ryood/RhythmMachine-V2/RhythmMachine Panel/P1110564.jpg

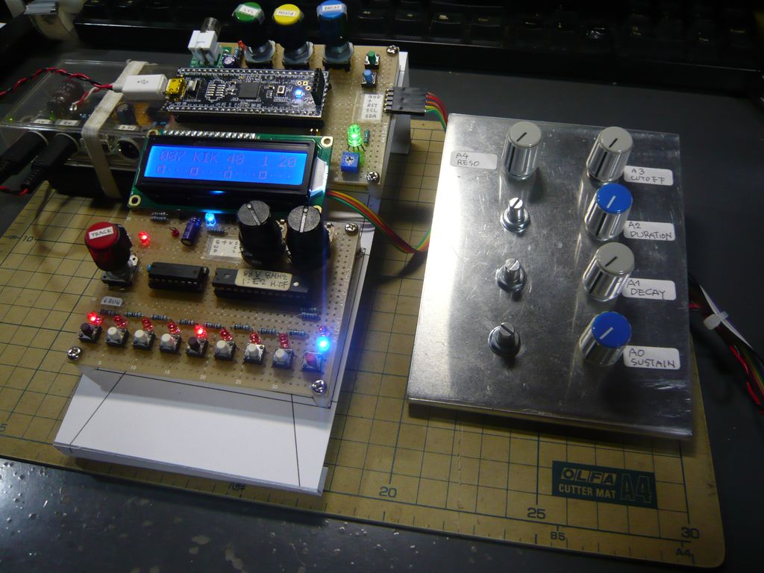
RhythmMachine Panel/P1110564.jpg
