ryood/RhythmMachine-V2/Master_PSoC5LP/Fritzing/PSoC 5LP Prototyping Kit & Sequencer Board & HD44780 REx3_ブレッドボード.png

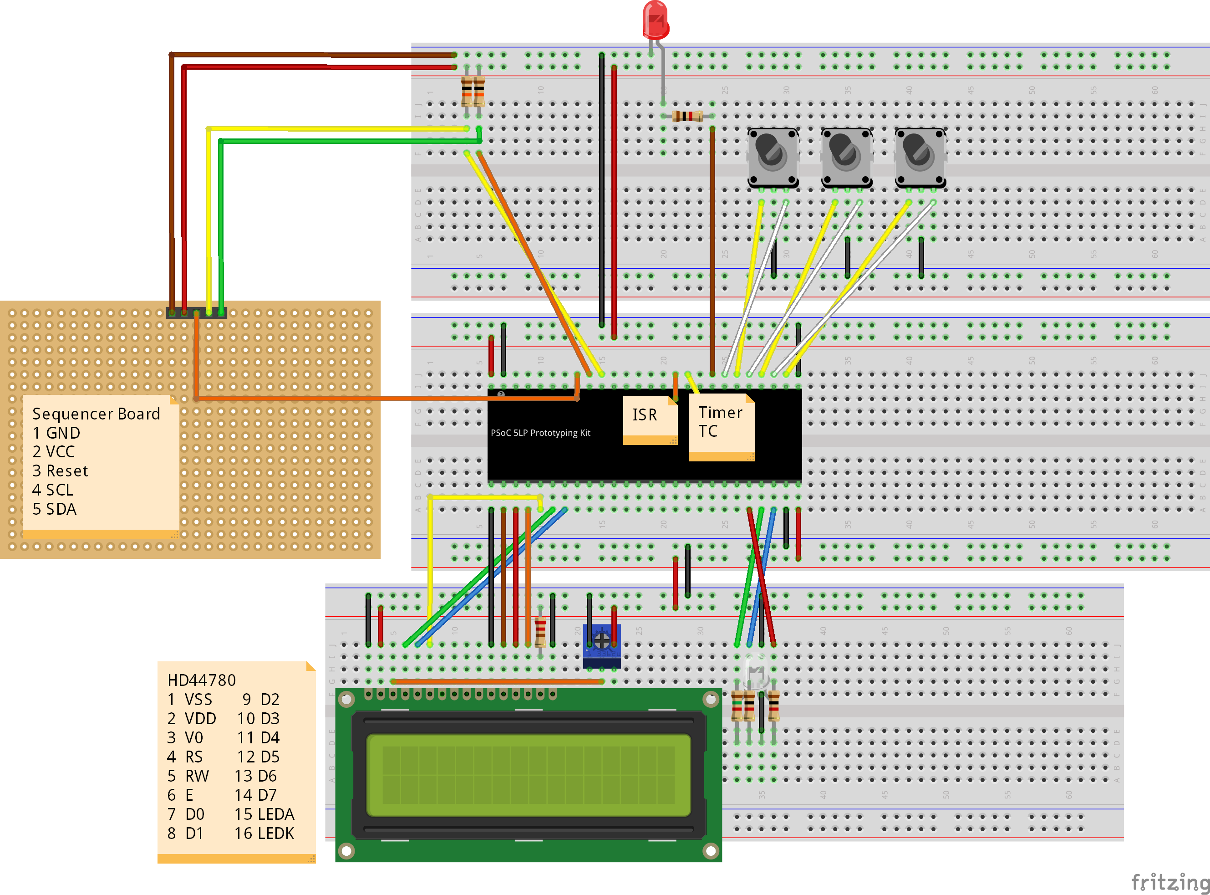
Master_PSoC5LP/Fritzing/PSoC 5LP Prototyping Kit & Sequencer Board & HD44780 REx3_ブレッドボード.png
