ryood/RhythmMachine-V2/Master_PSoC5LP/Fritzing/Rhythm Machine Master PSoC 5LP Prototyping Kit_ブレッドボード.png

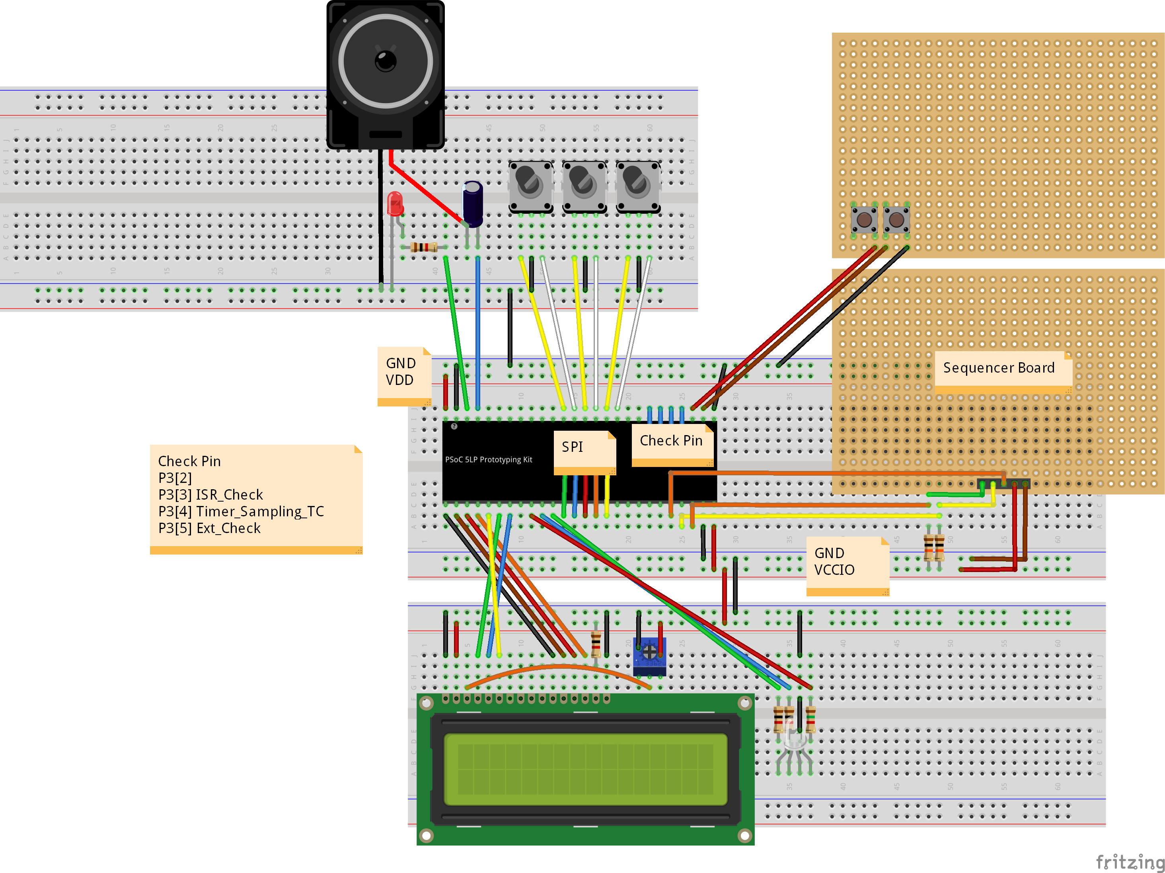
Master_PSoC5LP/Fritzing/Rhythm Machine Master PSoC 5LP Prototyping Kit_ブレッドボード.png
