ryood/RhythmMachine-V2/Master_PSoC5LP/RhythmMachine_Master_Board_Sch.png

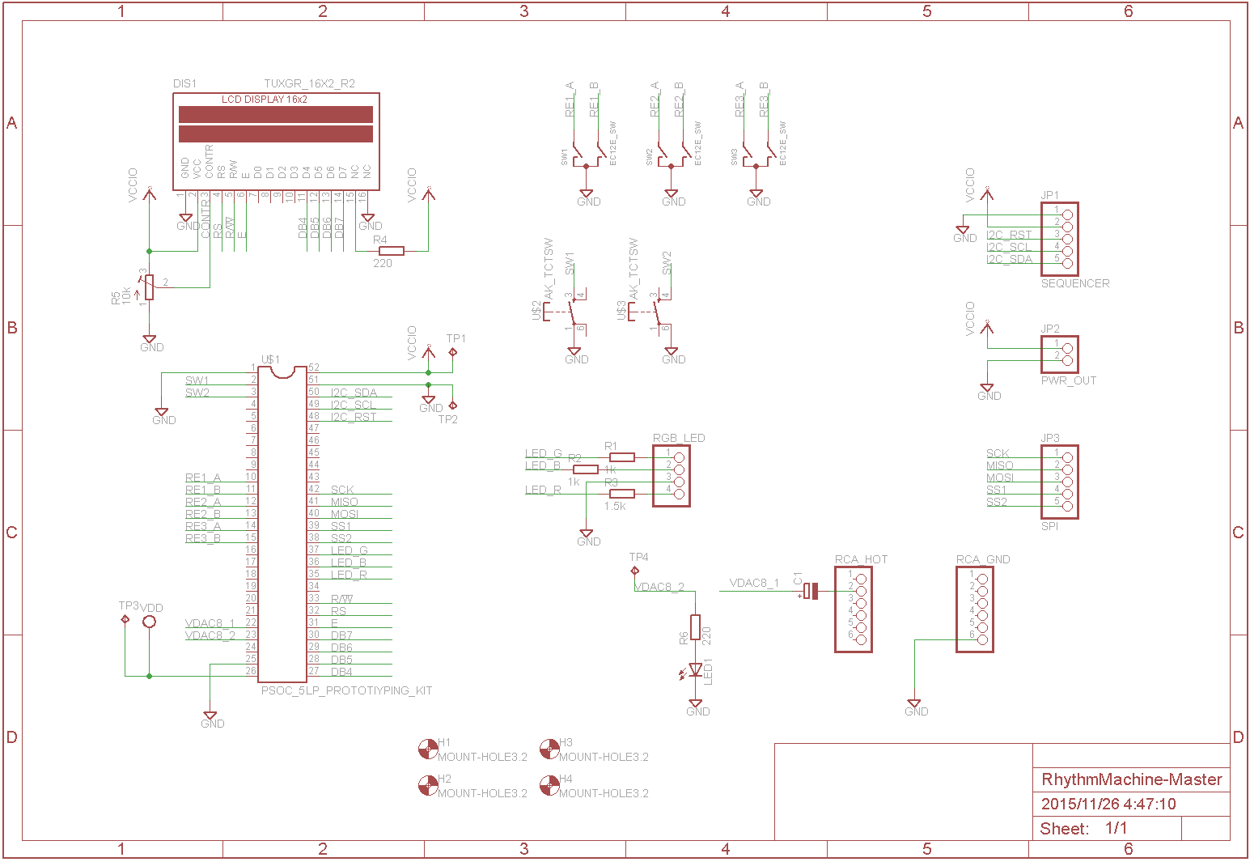
Master_PSoC5LP/RhythmMachine_Master_Board_Sch.png
