ryood/RhythmMachine-V2/Sequencer_Borard/Sequencer_brd.png

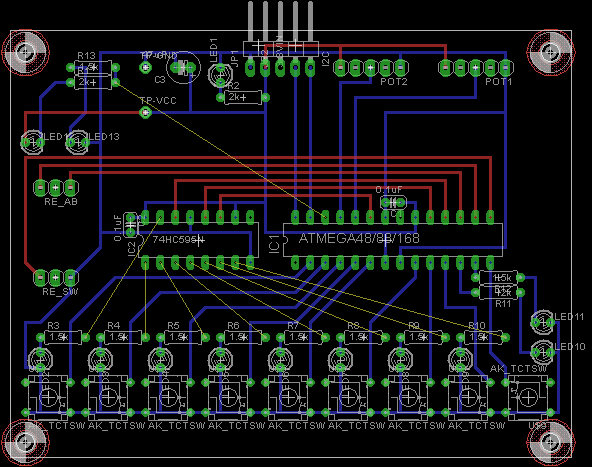
Sequencer_Borard/Sequencer_brd.png
