ryood/RhythmMachine-V2/Sequencer_Borard/Sequencer_IC接続表.png

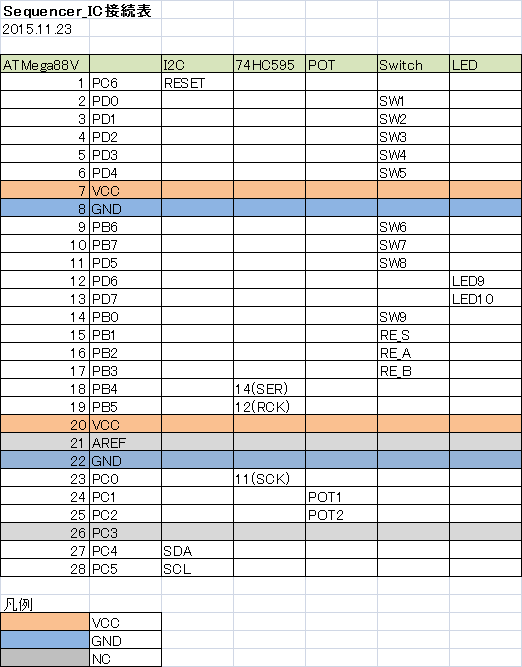
Sequencer_Borard/Sequencer_IC接続表.png
