ryood/RhythmMachine-V2/Sequencer_Borard/Sequencer_sch.png

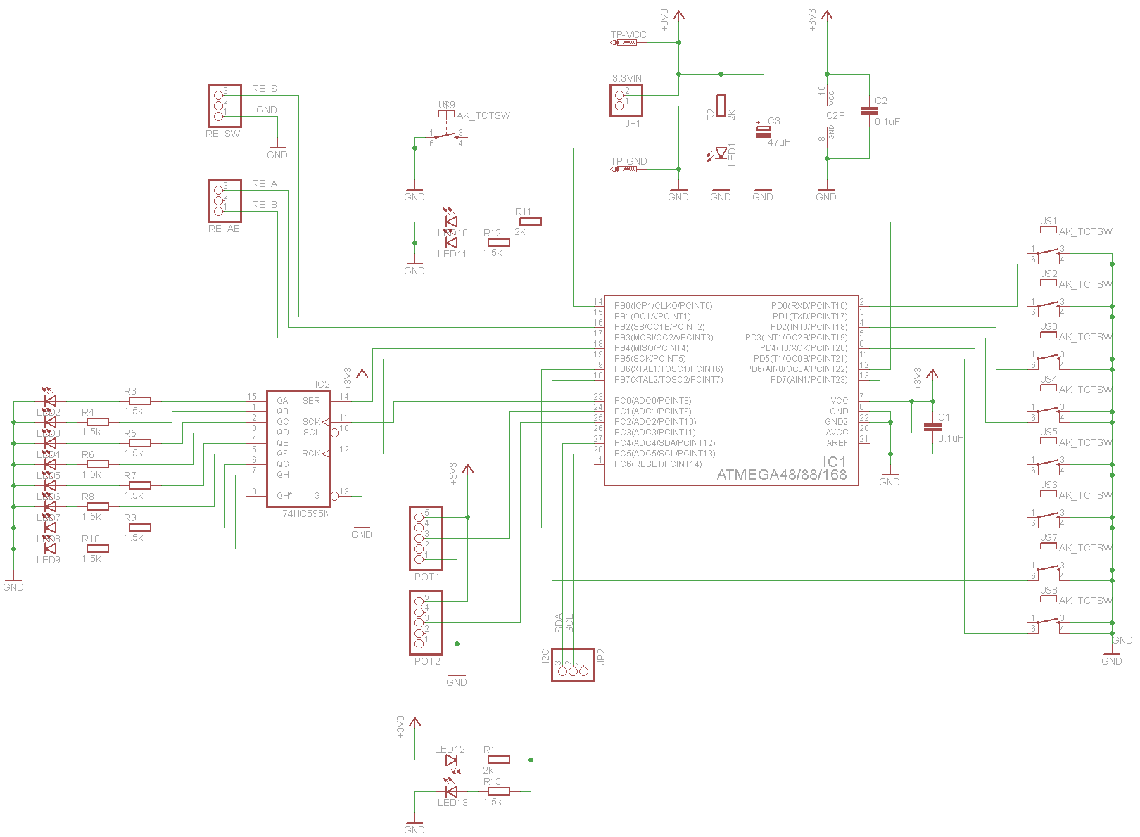
Sequencer_Borard/Sequencer_sch.png
