ryood/RhythmMachine-V2/Rhythm_Machine_I2C_データ・フォーマット.xlsx

Sheet: Sheet1
Rhythm Machine I2C データ・フォーマット
2015.11.15
1) Sequencer Board |  |  | I2C_ADDRESS: 0xFE
1.1) Slave→Master
No. | Sign | Name | 説明 | 備考
1 | unsigned | UPDATE | 変更の有無 | 0:変更なし ※sheet2 *1参照
2 | unsigned | TRACK | トラック番号 | 0..7
3 | unsigned | PLAY | シーケンスの再生フラグ | 1 再生 0:停止
4 | unsigned | SEQUENCE1 | Sequence 1.. 8 | LSBがシーケンス1
5 | unsigned | SEQUENCE2 | Sequence 9..17 | LSBがシーケンス9
6 | unsigned | POT1 | Pot1のADC読み取り値 | 4bit 0..15
7 | unsigned | POT2 | Pot2のADC読み取り値 | 4bit 0..15
1.2) Master→Slave
No. | Sign | Name | 説明 | 備考
1 | unsigned | NOTE | 再生中のノート・ナンバー | 0..15
2) Ext. Board |  |  | I2C_ADDRESS: 0xAA
2.1) Slave→Master
No. | Sign | Name | 説明 | 備考
1 |  | RE1 | ロータリーエンコーダー1の値 | 0..255
2 |  | RE2 | ロータリーエンコーダー2の値 | 0..255
3 |  | RE3 | ロータリーエンコーダー3の値 | 0..255
4 |  | SW | スイッチ（4個）のトグル状態 | B3:SW4 B2:SW3 B1:SW1 B0:SW0
2.2) Master→Slave
No. | Sign | Name | 説明 | 備考
1 |  | RE1 | ロータリーエンコーダー1の値 | 0..255
2 |  | RE2 | ロータリーエンコーダー2の値 | 0..255
3 |  | RE3 | ロータリーエンコーダー3の値 | 0..255
4 |  | SW | スイッチ（4個）のトグル状態 | B3:SW4 B2:SW3 B1:SW1 B0:SW0

Sheet: Sheet2
※1 UPDATE
b7 | b6 | b5 | b4 | b3 | b2 | b1 | b0
- | POT2 | POT1 | SEQUENCE2 | SEQUENCE1 | PLAY | TRACK | -
