ryood/RhythmMachine-V2/(list of files, cad)

Other CAD files:
RhythmMachine Panel/RhythmMachine_Panel.dwg
