ryood/RhythmMachine-V2/Sequencer_Borard/Sequencer_Test.xlsx

Sequencerテスト表
 | 2層目配線前、電源なし、ICの挿入なし
 | 項番 | Point1 | Point2 | 値 | 2015.09.19 #1
 | 1 | IC1-2 | GND | SW1 on/off | ok
 | 2 | IC1-3 | GND | SW2 on/off | ok
 | 3 | IC1-4 | GND | SW3 on/off | ok
 | 4 | IC1-5 | GND | SW4 on/off | ok
 | 5 | IC1-6 | GND | SW5 on/off | ok
 | 6 | IC1-7 | VCC | con | ok
 | 7 | IC1-8 | GND | con | ok
 | 8 | IC1-9 | GND | SW6 on/off | ok
 | 9 | IC1-10 | GND | SW7 on/off | ok
 | 10 | IC1-11 | GND | SW8 on/off | ok
 | 11 | ~~IC1-12~~ | ~~GND~~ | ~~3.3V LED10 on~~
 | 12 | IC1-13 | GND | 3.3V LED11 on | ok
 | 13 | IC1-14 | GND | SW9 on/off | ok
 | 14 | ~~IC1-15~~ | ~~GND~~ | ~~RE_SW on/off~~
 | 15 | ~~IC1-16~~ | ~~GND~~ | ~~RE_A on/off~~
 | 16 | ~~IC1-17~~ | ~~GND~~ | ~~RE_B on/off~~
 | 17 | ~~IC1-18~~ | ~~IC2-14~~ | ~~con~~
 | 18 | ~~IC1-19~~ | ~~IC2-12~~ | ~~con~~
 | 19 | IC1-20 | VCC | con | ok
 | 20 | IC1-21 | VCC/GND | nc | ok
 | 21 | IC1-22 | GND | con | ok
 | 22 | ~~IC1-23~~ | ~~IC2-11~~ | ~~con~~
 | 23 | IC1-24 | POT1-2 | con | ok
 | 24 | IC1-25 | POT2-2 | con | ok
 | 25 | ~~IC1-26~~ | ~~GND~~ | ~~-3.3V LED12 on~~
 | 26 | ~~IC1-26~~ | ~~GND~~ | ~~3.3V LED13 on~~
 | 27 | IC1-27 | JP2-3 | con | ok
 | 28 | IC1-28 | JP2-2 | con | ok
 | 29 | ~~IC2-1~~ | ~~GND~~ | ~~3.3V LED3 on~~
 | 30 | ~~IC2-2~~ | ~~GND~~ | ~~3.3V LED4 on~~
 | 31 | ~~IC2-3~~ | ~~GND~~ | ~~3.3V LED5 on~~
 | 32 | ~~IC2-4~~ | ~~GND~~ | ~~3.3V LED6 on~~
 | 33 | ~~IC2-5~~ | ~~GND~~ | ~~3.3V LED7 on~~
 | 34 | ~~IC2-6~~ | ~~GND~~ | ~~3.3V LED8 on~~
 | 35 | ~~IC2-7~~ | ~~GND~~ | ~~3.3V LED9 on~~
 | 36 | IC2-8 | GND | con | ok
 | 37 | IC2-9 | VCC/GND | nc | ok
 | 38 | IC2-10 | VCC | con | ok
 | 39 | IC2-13 | GND | con | ok
 | 40 | ~~IC2-15~~ | ~~GND~~ | ~~3.3V LED2 on~~
 | 41 | IC2-16 | VCC | con | ok
 | 42 | C1 | VCC | con | ok
 | 43 | C1 | GND | con | ok
 | 44 | C2 | VCC | con | ok
 | 45 | C2 | GND | con | ok
 | 46 | POT1-1 | GND | con | ok
 | 47 | ~~POT1-3~~ | ~~VCC~~ | ~~con~~
 | 48 | POT2-1 | GND | con | ok
 | 49 | ~~POT2-3~~ | ~~VCC~~ | ~~con~~
 | 50 | JP1-1 | GND | con | ok
 | 51 | JP1-2 | VCC | con | ok
 | 52 | TP-VCC | TP-GND | 3.3V LED1 on | ok
 | 53 | C3 | VCC | con | ok
 | 54 | C3 | GND | con | ok
 | 電源なし、ICの挿入なし
 | 項番 | Point1 | Point2 | 値 | 2015.09.21 #1
 | 1 | IC1-2 | GND | SW1 on/off | ok
 | 2 | IC1-3 | GND | SW2 on/off | ok
 | 3 | IC1-4 | GND | SW3 on/off | ok
 | 4 | IC1-5 | GND | SW4 on/off | ok
 | 5 | IC1-6 | GND | SW5 on/off | ok
 | 6 | IC1-7 | VCC | con | ok
 | 7 | IC1-8 | GND | con | ok
 | 8 | IC1-9 | GND | SW6 on/off | ok
 | 9 | IC1-10 | GND | SW7 on/off | ok
 | 10 | IC1-11 | GND | SW8 on/off | ok
 | 11 | IC1-12 | GND | 3.3V LED10 on | ok
 | 12 | IC1-13 | GND | 3.3V LED11 on | ok
 | 13 | IC1-14 | GND | SW9 on/off | ok
 | 14 | IC1-15 | GND | RE_SW on/off | ok
 | 15 | IC1-16 | GND | RE_A on/off | ok
 | 16 | IC1-17 | GND | RE_B on/off | ok
 | 17 | IC1-18 | IC2-14 | con | ok
 | 18 | IC1-19 | IC2-12 | con | ok
 | 19 | IC1-20 | VCC | con | ok
 | 20 | IC1-21 | VCC/GND | nc | ok
 | 21 | IC1-22 | GND | con | ok
 | 22 | IC1-23 | IC2-11 | con | ok
 | 23 | IC1-24 | POT1-2 | con | ok
 | 24 | IC1-25 | POT2-2 | con | ok
 | 25 | IC1-26 | GND | -3.3V LED12 on | ok
 | 26 | IC1-26 | GND | 3.3V LED13 on | ok
 | 27 | IC1-27 | JP2-3 | con | ok
 | 28 | IC1-28 | JP2-2 | con | ok
 | 29 | IC2-1 | GND | 3.3V LED3 on | ok
 | 30 | IC2-2 | GND | 3.3V LED4 on | ok
 | 31 | IC2-3 | GND | 3.3V LED5 on | ok
 | 32 | IC2-4 | GND | 3.3V LED6 on | ok
 | 33 | IC2-5 | GND | 3.3V LED7 on | ok
 | 34 | IC2-6 | GND | 3.3V LED8 on | ok
 | 35 | IC2-7 | GND | 3.3V LED9 on | ok
 | 36 | IC2-8 | GND | con | ok
 | 37 | IC2-9 | VCC/GND | nc | ok
 | 38 | IC2-10 | VCC | con | ok
 | 39 | IC2-13 | GND | con | ok
 | 40 | IC2-15 | GND | 3.3V LED2 on | ok
 | 41 | IC2-16 | VCC | con | ok
 | 42 | C1 | VCC | con | ok
 | 43 | C1 | GND | con | ok
 | 44 | C2 | VCC | con | ok
 | 45 | C2 | GND | con | ok
 | 46 | POT1-1 | GND | con | ok
 | 47 | POT1-3 | VCC | con | ok
 | 48 | POT2-1 | GND | con | ok
 | 49 | POT2-3 | VCC | con | ok
 | 50 | JP1-1 | GND | con | ok
 | 51 | JP1-2 | VCC | con | ok
 | 52 | TP-VCC | TP-GND | 3.3V LED1 on | ok
 | 53 | C3 | VCC | con | ok
 | 54 | C3 | GND | con | ok
 | 電源3.3V、ICの挿入なし
 | 項番 | Point1 | Point2 | 値 | 2015.09.21#1
 | 1 | IC1-7 | GND | 3.3V | 3.36V
 | 2 | IC1-8 | GND | 0V | 0.0mV
 | 3 | IC1-20 | GND | 3.3V | 3.36V
 | 4 | IC1-22 | GND | 0V | 0.0mV
 | 5 | IC2-8 | GND | 0V | 0.0mV
 | 6 | IC2-16 | GND | 3.3V | 3.36V
 | 7 | VCC | GND | 3.3V | 3.36V
