ryood/RhythmMachine-V2/(list of files, drawings)

Other design files:
Master_PSoC5LP/Fritzing/PSoC 5LP Prototyping Kit & Sequencer Board & HD44780 REx3.fzz
Sequencer_Borard/Fritzing/Sequencer_02.fzz
Sequencer_Borard/Fritzing/Sequencer_03.fzz
