ryood/RhythmMachine-V2/Master_PSoC5LP/eagle/RhythmMachine-Master/RhythmMachine-Master.brd

## EAGLE design Master_PSoC5LP/eagle/RhythmMachine-Master/RhythmMachine-Master.brd (2016-12-20)

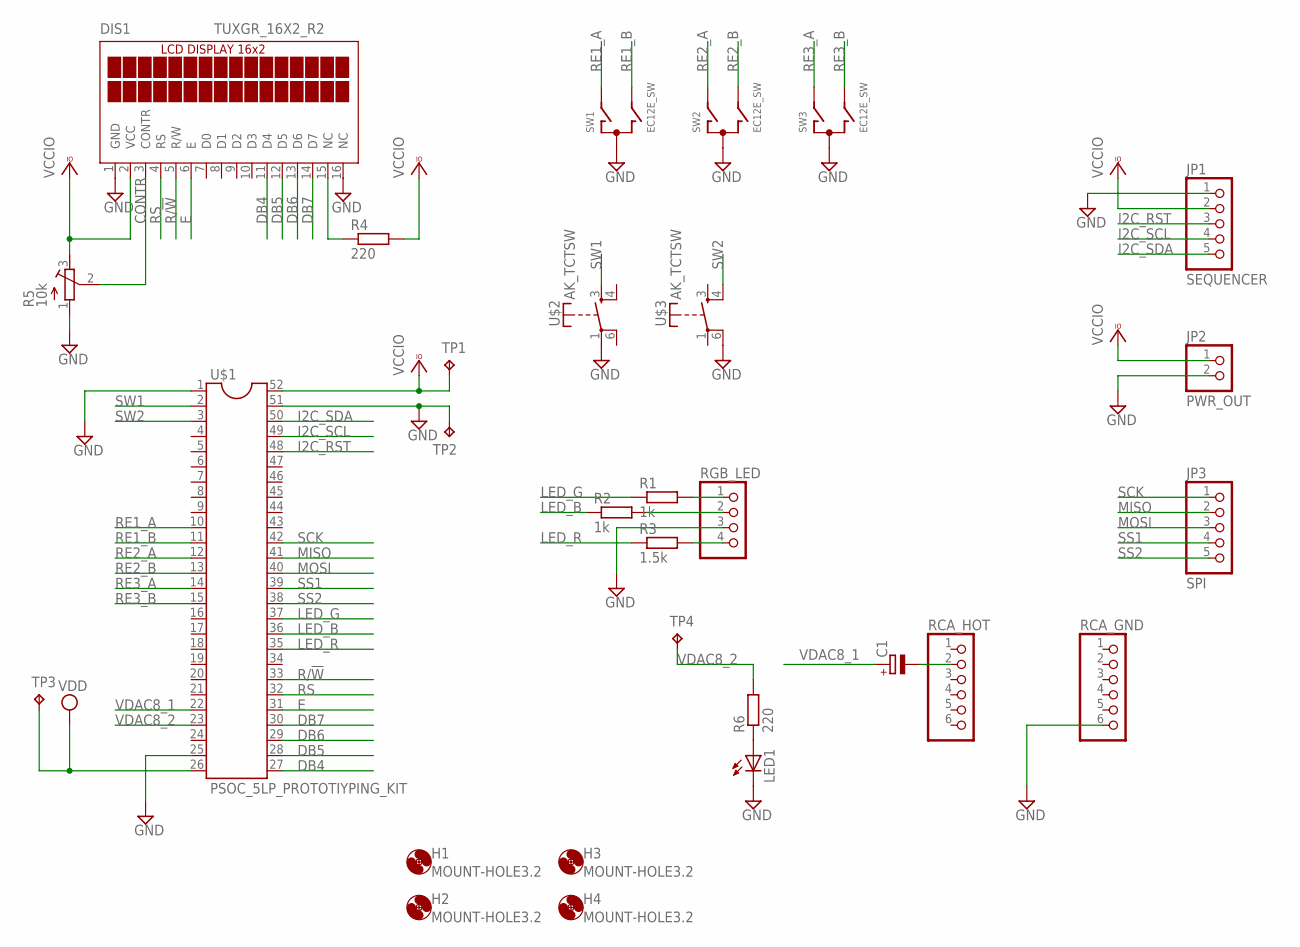
[picture p9: schematic RhythmMachine-Master.sch]

Parts:
C1: CPOL-EUE2.5-7; E2,5-7
DIS1: TUXGR_16X2_R2
H1, H2, H3, H4: MOUNT-HOLE3.2; 3,2
JP1: SEQUENCER; 1X05/90
JP2: PWR_OUT; 1X02/90
JP3: SPI; 1X05/90
LED1: LED3MM
R1, R2: 1k; 0207/7
R3: 1.5k; 0207/7
R4, R6: 220; 0207/7
R5: 10k; RTRIM3339P
RCA_GND: PINHD-1X6; 1X06
RCA_HOT: PINHD-1X6; 1X06
RGB_LED: PINHD-1X4; 1X04
SW1, SW2, SW3: EC12E_SW; ALPS_EC12E_SW
TP1, TP2, TP3, TP4: TPPAD1-13; P1-13
U$1: PSOC_5LP_PROTOTIYPING_KIT; DIL52-8
U$2, U$3: AK_TCTSW; TME1

Connections:
CONTR: DIS1.3 (CONTR), R5.2 (S)
DB4: DIS1.11 (D4), U$1.27
DB5: DIS1.12 (D5), U$1.28
DB6: DIS1.13 (D6), U$1.29
DB7: DIS1.14 (D7), U$1.30
E: DIS1.6 (E), U$1.31
GND: DIS1.1 (GND), DIS1.16 (NC), JP1.1, JP2.2, LED1.K (C), R5.1 (A), RCA_GND.6, RGB_LED.3, SW1.C, SW2.C, SW3.C, TP2.TP, U$1.1, U$1.25, U$1.51, U$2.1, U$3.6
I2C_RST: JP1.3, U$1.48
I2C_SCL: JP1.4, U$1.49
I2C_SDA: JP1.5, U$1.50
LED_B: R2.1, U$1.36
LED_G: R1.1, U$1.37
LED_R: R3.1, U$1.35
MISO: JP3.2, U$1.41
MOSI: JP3.3, U$1.40
unnamed: R1.2, RGB_LED.1
unnamed: R2.2, RGB_LED.2
unnamed: R3.2, RGB_LED.4
unnamed: DIS1.15 (NC), R4.1
unnamed: LED1.A, R6.1
unnamed: C1.-, RCA_HOT.2
R/!W: DIS1.5 (R/W), U$1.33
RE1_A: SW1.A, U$1.10
RE1_B: SW1.B, U$1.11
RE2_A: SW2.A, U$1.12
RE2_B: SW2.B, U$1.13
RE3_A: SW3.A, U$1.14
RE3_B: SW3.B, U$1.15
RS: DIS1.4 (RS), U$1.32
SCK: JP3.1, U$1.42
SS1: JP3.4, U$1.39
SS2: JP3.5, U$1.38
SW1: U$1.2, U$2.3 (S)
SW2: U$1.3, U$3.4 (S)
VCCIO: DIS1.2 (VCC), JP1.2, JP2.1, R4.2, R5.3 (E), TP1.TP, U$1.52
VDAC8_1: C1.+, U$1.22
VDAC8_2: R6.2, TP4.TP, U$1.23
VDD: TP3.TP, U$1.26

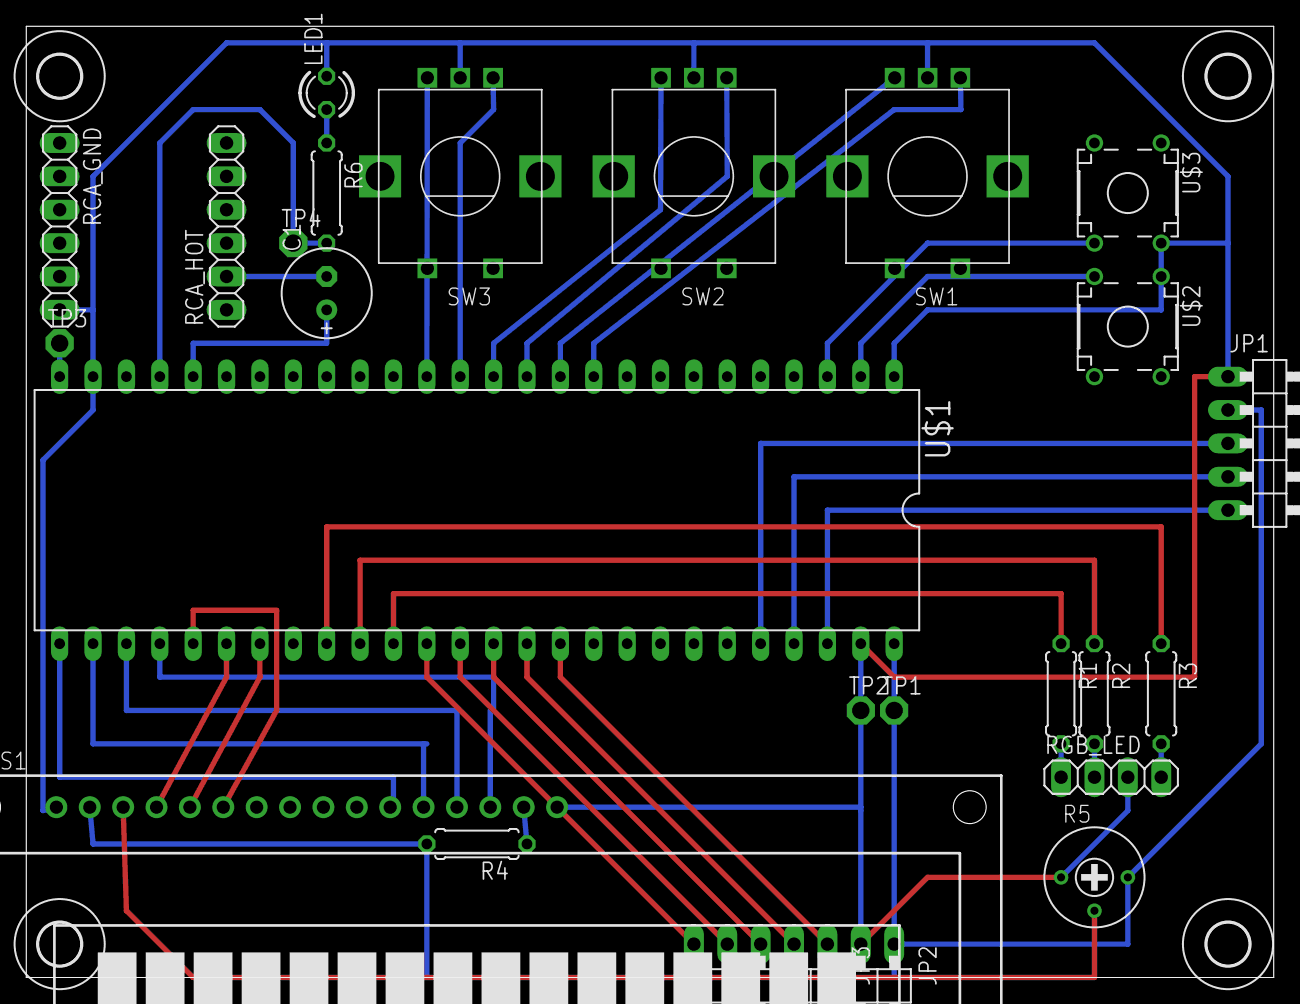
[picture p10: board RhythmMachine-Master.brd from above]

Board: 2 copper layers, 94.9 x 72.4 mm, 29 parts (0 on the bottom side), 38 nets.
