ryood/RhythmMachine-V2/Sequencer_Borard/eagle/Seaquencer.brd

## EAGLE design Sequencer_Borard/eagle/Seaquencer.brd (2016-12-20)

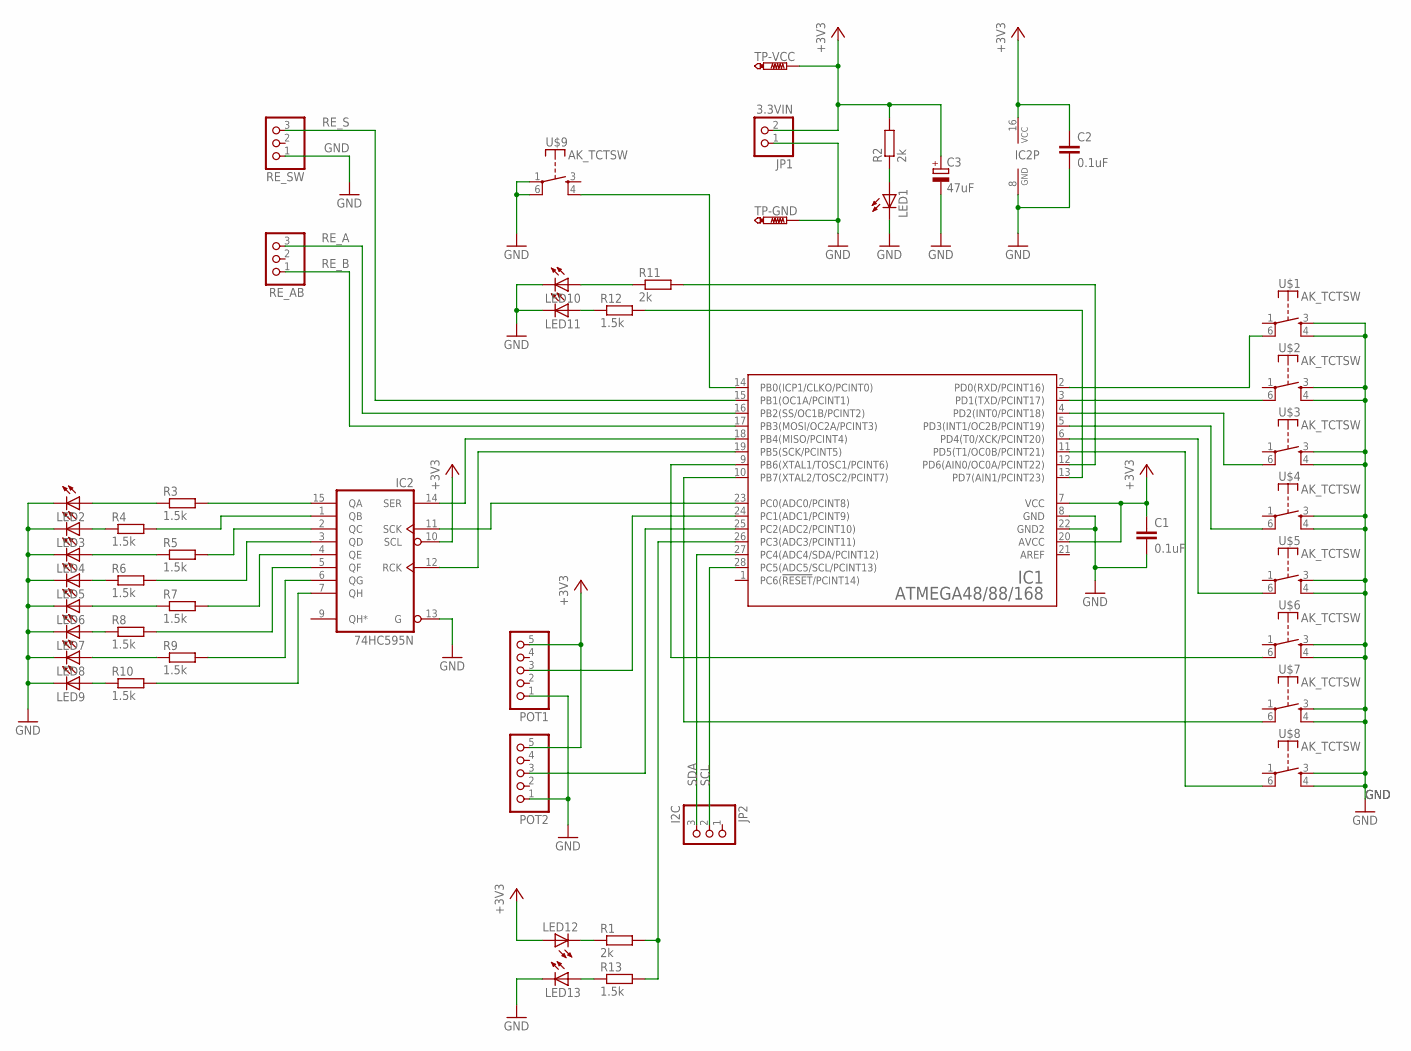
[picture p11: schematic Seaquencer.sch]

Parts:
C1, C2: 0.1uF; C025-024X044
C3: 47uF; E2,5-6
IC1: ATMEGA48/88/168; DIL28-3
IC2: 74HC595N; DIL16
JP1: 3.3VIN; 1X02/90
JP2: I2C; 1X03/90
LED1, LED2, LED3, LED4, LED5, LED6, LED7, LED8, LED9, LED10, LED11, LED12, LED13: LED3MM
POT1, POT2: PINHD-1X5; 1X05
R1, R2, R11: 2k; 0207/7
R3, R4, R5, R6, R7, R8, R9, R10, R12, R13: 1.5k; 0207/7
RE_AB: PINHD-1X3; 1X03
RE_SW: PINHD-1X3; 1X03
TP-GND: PTR1PAD1-13; P1-13
TP-VCC: PTR1PAD1-13; P1-13
U$1, U$2, U$3, U$4, U$5, U$6, U$7, U$8, U$9: AK_TCTSW; TME1

Connections:
+3V3: C1.1, C2.1, C3.+, IC1.7 (VCC), IC1.20 (AVCC), IC2.10 (SCL), IC2.16 (VCC), JP1.2, LED12.A, POT1.5, POT2.5, R2.2, TP-VCC.TP
GND: C1.2, C2.2, C3.-, IC1.8 (GND), IC1.22 (GND2), IC2.8 (GND), IC2.13 (G), JP1.1, LED1.K (C), LED2.K (C), LED3.K (C), LED4.K (C), LED5.K (C), LED6.K (C), LED7.K (C), LED8.K (C), LED9.K (C), LED10.K (C), LED11.K (C), LED13.K (C), POT1.1, POT2.1, RE_SW.1, TP-GND.TP, U$1.3 (S), U$1.4 (S), U$2.3 (S), U$2.4 (S), U$3.3 (S), U$3.4 (S), U$4.3 (S), U$4.4 (S), U$5.3 (S), U$5.4 (S), U$6.3 (S), U$6.4 (S), U$7.3 (S), U$7.4 (S), U$8.3 (S), U$8.4 (S), U$9.1, U$9.6
unnamed: IC1.2 (PD0(RXD/PCINT16)), U$1.6
unnamed: IC1.3 (PD1(TXD/PCINT17)), U$2.6
unnamed: IC1.11 (PD5(T1/OC0B/PCINT21)), U$8.6
unnamed: IC1.10 (PB7(XTAL2/TOSC2/PCINT7)), U$7.6
unnamed: IC1.9 (PB6(XTAL1/TOSC1/PCINT6)), U$6.6
unnamed: IC1.6 (PD4(T0/XCK/PCINT20)), U$5.6
unnamed: IC1.5 (PD3(INT1/OC2B/PCINT19)), U$4.6
unnamed: IC1.18 (PB4(MISO/PCINT4)), IC2.14 (SER)
unnamed: IC1.23 (PC0(ADC0/PCINT8)), IC2.11 (SCK)
unnamed: IC1.24 (PC1(ADC1/PCINT9)), POT1.3
unnamed: IC1.25 (PC2(ADC2/PCINT10)), POT2.3
unnamed: IC1.19 (PB5(SCK/PCINT5)), IC2.12 (RCK)
unnamed: IC1.14 (PB0(ICP1/CLKO/PCINT0)), U$9.4 (S)
unnamed: IC1.26 (PC3(ADC3/PCINT11)), R1.2, R13.2
unnamed: LED1.A, R2.1
unnamed: IC2.15 (QA), R3.2
unnamed: IC2.1 (QB), R4.2
unnamed: IC2.2 (QC), R5.2
unnamed: IC2.3 (QD), R6.2
unnamed: IC2.4 (QE), R7.2
unnamed: IC2.5 (QF), R8.2
unnamed: IC2.6 (QG), R9.2
unnamed: IC2.7 (QH), R10.2
unnamed: LED2.A, R3.1
unnamed: LED3.A, R4.1
unnamed: LED4.A, R5.1
unnamed: LED5.A, R6.1
unnamed: LED6.A, R7.1
unnamed: LED7.A, R8.1
unnamed: LED8.A, R9.1
unnamed: LED9.A, R10.1
unnamed: LED12.K (C), R1.1
unnamed: LED11.A, R12.1
unnamed: LED10.A, R11.1
unnamed: IC1.13 (PD7(AIN1/PCINT23)), R12.2
unnamed: IC1.12 (PD6(AIN0/OC0A/PCINT22)), R11.2
unnamed: LED13.A, R13.1
unnamed: IC1.4 (PD2(INT0/PCINT18)), U$3.6
RE_A: IC1.16 (PB2(SS/OC1B/PCINT2)), RE_AB.3
RE_B: IC1.17 (PB3(MOSI/OC2A/PCINT3)), RE_AB.1
RE_S: IC1.15 (PB1(OC1A/PCINT1)), RE_SW.3
SCL: IC1.28 (PC5(ADC5/SCL/PCINT13)), JP2.2
SDA: IC1.27 (PC4(ADC4/SDA/PCINT12)), JP2.3

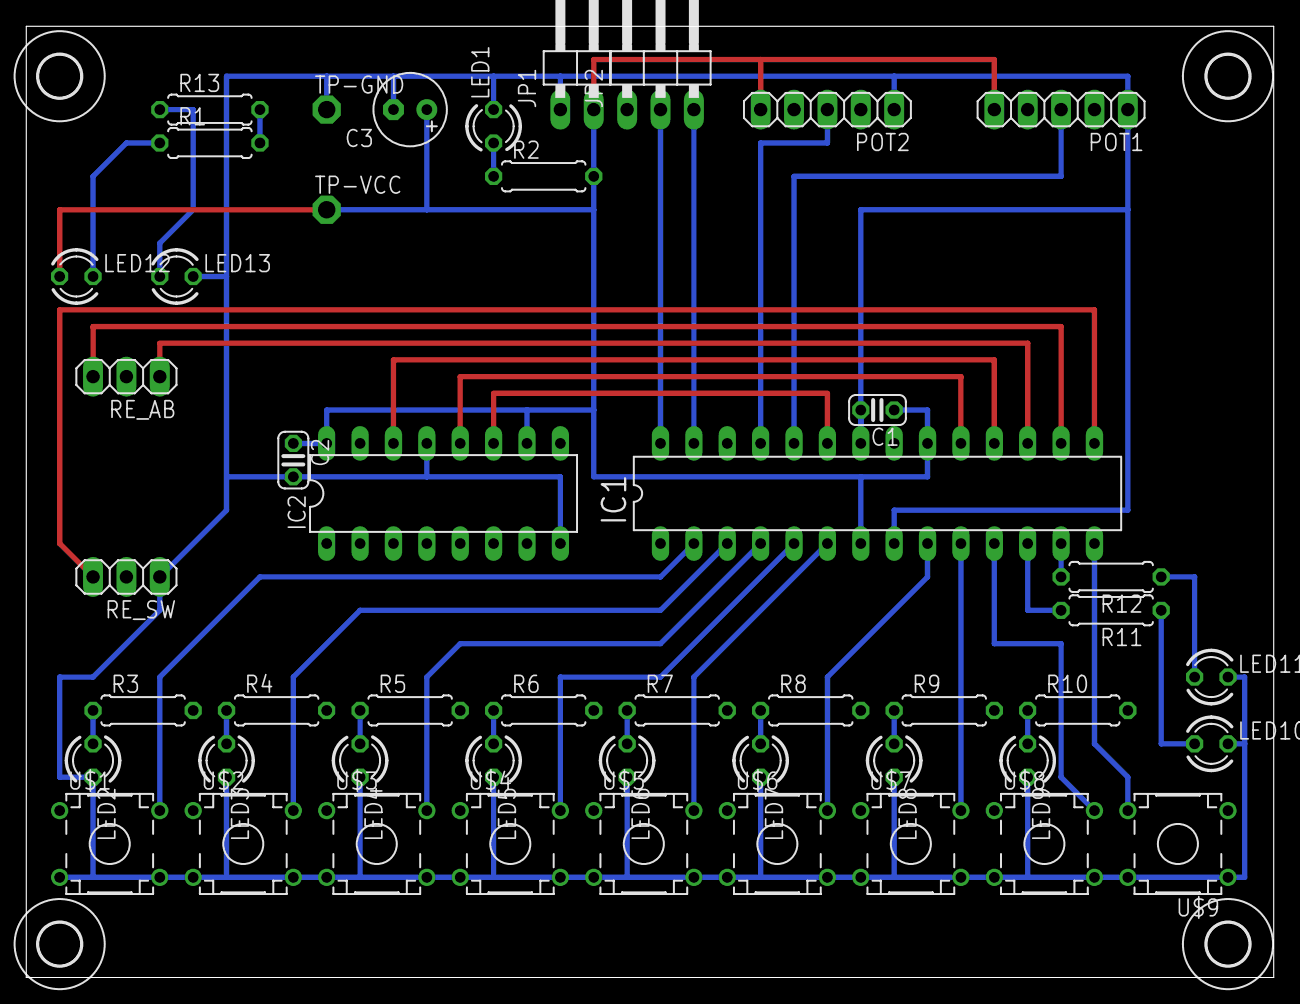
[picture p12: board Seaquencer.brd from above]

Board: 2 copper layers, 94.9 x 72.4 mm, 52 parts (0 on the bottom side), 45 nets.

Other parts of the board:
U$10, U$11, U$12, U$13: 3,2
