ryood/RhythmMachine-V2/Master_PSoC5LP/PSoC/Sequencer_Master/Sequencer_Master_PSoC5LP_ProtoKit_HD44780.cydsn/WaveTableFp32.h

// table of fp32 Q16 (-1.0 .. +1.0), 1024 values / one period
#include "fixedpoint.h"

//-----------------------------------------------------------------------------
// Sine Wave
//
const fp32 waveTableSine[] = {
	0	,
	402	,
	804	,
	1206	,
	1608	,
	2010	,
	2412	,
	2814	,
	3215	,
	3617	,
	4018	,
	4420	,
	4821	,
	5222	,
	5622	,
	6023	,
	6423	,
	6823	,
	7223	,
	7623	,
	8022	,
	8421	,
	8819	,
	9218	,
	9616	,
	10013	,
	10410	,
	10807	,
	11204	,
	11600	,
	11995	,
	12390	,
	12785	,
	13179	,
	13573	,
	13966	,
	14359	,
	14751	,
	15142	,
	15533	,
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
};

//-----------------------------------------------------------------------------
// Square Wave
//
const fp32 waveTableSquare[] = {
	65535,
	65535,
	65535,
	65535,
	65535,
	65535,
	65535,
	65535,
	65535,
	65535,
	65535,
	65535,
	65535,
	65535,
	65535,
	65535,
	65535,
	65535,
	65535,
	65535,
	65535,
	65535,
	65535,
	65535,
	65535,
	65535,
	65535,
	65535,
	65535,
	65535,
	65535,
	65535,
	65535,
	65535,
	65535,
	65535,
	65535,
	65535,
	65535,
	65535,
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
};

//-----------------------------------------------------------------------------
// Saw Up Wave
//
const fp32 waveTableSawUp[] = {
	0,
	63,
	127,
	191,
	255,
	319,
	383,
	447,
	511,
	575,
	639,
	703,
	767,
	831,
	895,
	959,
	1023,
	1087,
	1151,
	1215,
	1279,
	1343,
	1407,
	1471,
	1535,
	1599,
	1663,
	1727,
	1791,
	1855,
	1919,
	1983,
	2047,
	2111,
	2175,
	2239,
	2303,
	2367,
	2431,
	2495,
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
};

//-----------------------------------------------------------------------------
// Triangle Wave
//
const fp32 waveTableTriangle[] = {
	0,
	127,
	255,
	383,
	511,
	639,
	767,
	895,
	1023,
	1151,
	1279,
	1407,
	1535,
	1663,
	1791,
	1919,
	2047,
	2175,
	2303,
	2431,
	2559,
	2687,
	2815,
	2943,
	3071,
	3199,
	3327,
	3455,
	3583,
	3711,
	3839,
	3967,
	4095,
	4223,
	4351,
	4479,
	4607,
	4735,
	4863,
	4991,
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
	};
