ryood/RhythmMachine-V2/Master_PSoC5LP/PSoC/Sequencer_Master/Sequencer_Master_PSoC5LP_ProtoKit_HD44780.cydsn/ModTableFp32.h

// table of fp32 Q16 (-1.0 .. +1.0), 128 values / one period
#include "fixedpoint.h"

const fp32 modTableAllMax[] = {
	65535	,
	65535	,
	65535	,
	65535	,
	65535	,
	65535	,
	65535	,
	65535	,
	65535	,
	65535	,
	65535	,
	65535	,
	65535	,
	65535	,
	65535	,
	65535	,
	65535	,
	65535	,
	65535	,
	65535	,
	65535	,
	65535	,
	65535	,
	65535	,
	65535	,
	65535	,
	65535	,
	65535	,
	65535	,
	65535	,
	65535	,
	65535	,
	65535	,
	65535	,
	65535	,
	65535	,
	65535	,
	65535	,
	65535	,
	65535	,
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
};
   
const fp32 modTableLinerDown01[] = {
	65024,
	64512,
	64000,
	63488,
	62976,
	62464,
	61952,
	61440,
	60928,
	60416,
	59904,
	59392,
	58880,
	58368,
	57856,
	57344,
	56832,
	56320,
	55808,
	55296,
	54784,
	54272,
	53760,
	53248,
	52736,
	52224,
	51712,
	51200,
	50688,
	50176,
	49664,
	49152,
	48640,
	48128,
	47616,
	47104,
	46592,
	46080,
	45568,
	45056,
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
};

const fp32 modTableRampDown01[] = {
	65535	,
	63005	,
	60572	,
	58234	,
	55986	,
	53824	,
	51746	,
	49749	,
	47828	,
	45982	,
	44207	,
	42500	,
	40859	,
	39282	,
	37765	,
	36307	,
	34906	,
	33558	,
	32263	,
	31017	,
	29820	,
	28668	,
	27562	,
	26498	,
	25475	,
	24491	,
	23546	,
	22637	,
	21763	,
	20923	,
	20115	,
	19338	,
	18592	,
	17874	,
	17184	,
	16520	,
	15883	,
	15270	,
	14680	,
	14113	,
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
};

const fp32 modTableSustainBeforeRampDown01[] = {
	65535	,
	65535	,
	65535	,
	65535	,
	65535	,
	65535	,
	65535	,
	65535	,
	65535	,
	65535	,
	65535	,
	65535	,
	65535	,
	65535	,
	65535	,
	65535	,
	65535	,
	65535	,
	65535	,
	65535	,
	65535	,
	65535	,
	65535	,
	65535	,
	65535	,
	65535	,
	65535	,
	65535	,
	65535	,
	65535	,
	65535	,
	65535	,
	65535	,
	65535	,
	65535	,
	65535	,
	65535	,
	65535	,
	65535	,
	65535	,
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
};
