ryood/RhythmMachine-V2/(commit log)

2016-12-20 Version 2
    [PSoC 5LP Prototyping Kit & Sequencer Board & HD44780 REx3.fzz, Rhythm Machine Main Board PSoC 5LP Prototyping Kit Pin Assign.xlsx, RhythmMachine-Master.brd, RhythmMachine-Master.sch, RhythmMachine_Master_Board_テスト表20151125.xlsx, Rhythm_Machine_I2C_データ・フォーマット.xlsx, Seaquencer.brd, Seaquencer.sch]
2016-12-20 Add: the panel design files
    [RhythmMachine_Panel.dwg]
2017-01-25 Test: Output a sync signal to the Pin_ISR_Check(P3_3)
    [RhythmMachine_Panel.dwg]
